SanjunaRathnamalala/Ghost_Alert/firmware/esp32_gateway/secrets.h

#pragma once
// NEVER commit this file. Add "firmware/esp32_gateway/secrets.h" to .gitignore.
#define WIFI_SSID    "Sanjuna"
#define WIFI_PASS    "11111111"
#define BACKEND_URL  "http://172.20.10.3:8000/api/v1/ingest" 
#define GATEWAY_KEY  "hjCK96bn4sjaT9mCgo77-AnTZtgKh0GBJ0pULw5pmgQ"
#define GATEWAY_ID   "esp32-gw-01"
